eedstrom/pronation/README.md

# Pronation Project

This is a repo for Group 2's pronation measurement project in PHYS 398 DLP

## Copyright and License

Unless otherwise noted, all code is:

Copyright (C) 2021 Dominic Culotta, Eric Edstrom, Jae Young Lee, Teagan Mathur, Brian Petro, Wilma Rishko, Ruizhi Wang

Please see `additional_copyrights.md` for information about other files' copyrights.

This work is licensed under the GNU General Public License (GPL) version 3 or later.  See `LICENSE.md` for more information.
