eedstrom/pronation/additional_copyrights.md

File `Arduino_LSM9DS1.h` is Copyright (C) 2019 Arduino SA.

File `Adafruit_LSM9DS1.h` is Copyright (C) 2020 Kevin (KTOWN) Townsend for Adafruit Industries.

File `Adafruit_Sensor.h` is Copyright (C) 2008 The Android Open Source Project.

File `Adafruit_GPS.h` is Copyright (C) 2012 Adafruit Industries.

File `SdFat.h` is Copyright (C) 2011-2020 Bill Greiman.

File `SD.h` is Copyright (C) 2010 SparkFun Electronics.

File `SPI.h` is Copyright (C) 2010 Cristian Maglie.

File `Wire.h` is Copyright (C) 2006 Nicholas Zambetti.

File `RTC.h` is Copyright (C) 2009 Amadeusz Jasak.

File `LiquidCrystal.h` is Copyright (C) 2006-2008 Hans-Christoph Steiner and Copyright (C) 2010 Arduino LLC.

Python library `numpy` is Copyright 2005-2021 NumPy Developers.

Python library `pandas` is Copyright 2008-2011 AQR Capital Management, LLC.

Python library `matplotlib` is Copyright (C) 2002-2011 John D. Hunter; All rights reserved.

Python library `seaborn` is Copyright (C) 2012-2020 Michael Waskom.

Python library `scipy` is Copyright (C) 2021 SciPy Developers.

Python library `OpenCV` is Copyright (C) 2021 OpenCV team.
