eedstrom/pronation/latex_paper/titlepage.tex

% Title page
\begin{titlepage}
  \begin{center}
    \vspace*{1cm}

    \Huge
    Measuring Pronation and Supination Using Accelerometers and Force-Sensitive Resistors

    \vspace{1.5cm}

    \large Brian Petro, Teagan Mathur, Eric Edstrom, Wilma Rishko,
    Jae Young Lee, Ruizhi Wang, Dominic Culotta

    \vspace{0.8cm}

    % Include the school seal because why not?
    

    \vfill

    \Large
    University of Illinois at Urbana-Champaign\\
    PHYS 398 DLP\\
    April 23, 2021

    \end{center}
  \end{titlepage}
