eedstrom/pronation/(commit log)

2021-02-14 Added code to read acc data to sd
    [TESTFILE.CSV]
2021-02-21 Added code to read from 3 accelerometers
    [RESTDATA0.CSV, RESTDATA1.CSV, TESTFILE_OLDFORMAT.CSV]
2021-02-22 put new data format into data frames.
2021-02-24 used the walking data from jae
    [Walking.CSV]
2021-02-26 Eliminated capitals
    [RESTDATA0.CSV, RESTDATA1.CSV, TESTFILE_OLDFORMAT.CSV, Walking.CSV]
2021-02-26 Removed capitals
    [restdata0.csv, restdata1.csv, testfile_oldformat.csv, walking.csv]
2021-02-26 removed old folders
    [RESTDATA0.CSV, RESTDATA1.CSV, TESTFILE_OLDFORMAT.CSV, Walking.CSV, restdata0.csv, restdata1.csv, testfile_oldformat.csv, walking.csv]
2021-02-26 Fixed accelerometer reading
    [restdata0.csv, restdata1.csv, testfile_oldformat.csv]
2021-02-26 Corrected accelerometer readings
    [restdata0.csv, restdata1.csv, restdata_new.csv, testfile_oldformat.csv]
2021-02-26 Added Magnetic Field Readings
    [restdata_with_mag.csv]
2021-02-28 Added a way to calculate gyro position.
2021-02-28 Added tilt to data acq
    [restdata_tilt.csv]
2021-03-05 used some noise filters and added tilt EQ
    [running_on_treadmil.csv]
2021-03-05 Commented print statements & changed how file is read
2021-03-05 Added Data with new Arduino Code
    [restdata_noprint.csv, restdata_print.csv]
2021-03-12 split accel graphs
    [noprint.csv]
2021-03-14 Removed some print statements
2021-03-16 kalman filter to calc tilt
    [test_two.csv]
2021-03-19 Fix spelling error in Kalman
    [MPU6050_HMC5883L.ino, kalmantilt3accel.ino, tilt_w_kalman.ino]
2021-03-19 stored some csvs
    [noprint.csv, restdata_new.csv, restdata_noprint.csv, restdata_print.csv, restdata_tilt.csv, restdata_with_mag.csv, running_on_treadmil.csv, walking.csv]
2021-03-19 added hello and retired some code
    [mostlystillwithkalmanfilter.CSV]
2021-03-23 Added FSR quiet stance, walking, and running data
    [QuietStanceFSR.CSV, RunningFSR.CSV, WalkingFSR.CSV]
2021-03-25 Changed id's of FSRs to not conflict with accelerometer bus numbers
2021-03-26 Made rest data plots and tables
    [rest_data.csv]
2021-03-26 Added LEDs, Keypad, and LCD
2021-03-26 Teagan's changes
    Modified dacwithled to fix led 6. Deleted some bad csv files. Moved FSR data to its own folder. Altered plotting python files to read appropriate files
    [QuietStance.CSV, QuietStanceFSR.CSV, RunningFSR.CSV, Walking.CSV, WalkingFSR.CSV]
2021-03-26 Walking and standing still accel and fsr data
    [QuietStance.CSV, Walking.CSV]
2021-03-26 Running data with fsr and accel from MultiAccelData.ino dac
    [Running.CSV]
2021-03-26 Fixed empty file problem and LED blinks 1/2 second
    [MultiAccelData.ino]
2021-04-01 Data from the March 31st Loomis group data collection meet-up
    [3.31_Loomis_Data.CSV]
2021-04-02 Add seperate csvs from pykalman branch
    [3.31_Loomis_1st.csv, 3.31_Loomis_2nd.csv, 3.31_Loomis_3rd.csv, 3.31_Loomis_4th.csv, 3.31_Loomis_5th.csv]
2021-04-02 Organizing csv files
    [QuietStance.CSV, Running.CSV, Walking.CSV]
2021-04-02 Files moved to the 3.26_Teagan_Apartment_Data folder
    [QuietStance.CSV, Running.CSV, Walking.CSV]
2021-04-02 Update MultiAccelData.ino
    add in the comma at the end of the print statements
2021-04-02 Plotted graphs with roll and pitch. Yaw in progress
    [df0.csv, df1.csv, df2.csv, df3.csv, df4.csv]
2021-04-02 Yaw IP
2021-04-03 Found the issue with yaw - my is str not float
2021-04-04 added a start to the complimentary filter
2021-04-05 Added some explination for the compliment filter
2021-04-06 added yaw calc.s
2021-04-06 Fixed yaw & popped header row
2021-04-06 Plotted all gyro data from 3.31 Loomis
2021-04-06 Started the comp filter - WIP
2021-04-07 Added the comp filter to all_together.py
2021-04-07 Added plotting functions for the complimentary filter and integration method
2021-04-07 Added initial values to the complimentary filter
2021-04-08 Data from April 7th Loomis Meet
    Wilma
    's 2nd data grab should be ignored
    [Teagan.CSV, Wilma.CSV]
2021-04-09 Fix shebang and permissions
    [3.31_Loomis_Data.CSV, QuietStance.CSV, QuietStanceFSR.CSV, Running.CSV, RunningFSR.CSV, Teagan.CSV, Walking.CSV, WalkingFSR.CSV]
2021-04-09 Made file separater its own file & added plotting fsrs in all_together.py
    [df0.csv, df1.csv, df2.csv, df3.csv, df4.csv, df5.csv]
2021-04-12 Add files via upload
    1. standing supination 2. standing pronation 3. walking pronation 4. walking supination 5. walking pronation then supination halfway
    [intentionalpro_sup.CSV]
2021-04-14 Added functions to compare known data to observed data
    [standing_pron.csv, standing_sup.csv, walk_both.csv, walk_pron.csv, walk_sup.csv]
2021-04-16 Separated the fanciest data
    [df0.csv, df1.csv]
2021-04-23 Data from April 7th Loomis data meet
    [Teagan.CSV, Wilma.CSV, df0.csv, df1.csv, df2.csv, df3.csv, df4.csv, df5.csv]
2021-04-23 Corrected data folder names
    [Teagan.CSV, Wilma.CSV, df0.csv, df1.csv, df2.csv, df3.csv, df4.csv, df5.csv]
2021-04-23 changed pitch's artan2 to arctan
